wZuck/DELTA-OMEGA-KS-33-Ver./README.md

[English](README.md) | [简体中文](README.zh-CN.md)

DELTA OMEGA KS-33 Ver.

# DELTA OMEGA KS-33 Ver.

A portable low-profile wireless 3×5+2 split keyboard.

> [!IMPORTANT]
> DELTA OMEGA KS-33 Ver. is a modification of the original DELTA OMEGA design,
> converted to the **Gateron KS-33 Low Profile 3.0 five-pin** switch platform.
> The split wireless architecture and compact 3×5+2 layout are retained. The
> main changes are the KS-33 PCB footprints, matrix routing and validation,
> direct-solder switch installation, KS-33-specific case clearance with a
> raised outer rim, the matching keycap fit envelope, and updated firmware,
> BOM, build, and mechanical documentation. The original Rev4 ULP PCB and
> Gerbers remain available for reference.

## Overview

- Switch support: Gateron KS-33 Low Profile 3.0, five-pin MX PCB layout
- 34 keys, splayed and staggered with 18 × 17 mm key pitch
- Wireless
- CNC aluminum case

## Parameters

Dimension

Layout

## Documentation

> [!NOTE]
> Rev5 is a **five-pin low-profile MX** build. It keeps the compact 18 × 17 mm layout, so keycap footprint must be checked before ordering: standard 19.05 mm-spaced MX keycaps can interfere between rows. The original Rev4 ULP PCB and Gerbers remain in the repository for reference.

- [Getting Started](./docs/GETTING_STARTED.md)
- [Rev5 Mechanical Notes](./docs/MECHANICAL.md)
- [Rev5 Review Summary](./docs/REVIEW_REV5.md)
- [Bill of Materials](./docs/BOM.md)
- [Build Guides](./docs/BUILD_GUIDES.md)
- [Video](https://youtu.be/UktrqN3MlLI)
- [PCB](./pcb/README.md)
- [Case](./case/README.md)
- [Firmware Notes](./firmware/README.md)
- [ZMK Keyboard Module](https://github.com/unspecworks/zmk-keyboard-delta-omega)
- [Pre-conf ZMK Config](https://github.com/unspecworks/zmk-delta-omega)
- Keycaps
  - [Rev5 fit envelope and requirements](./docs/MECHANICAL.md)

## Photos

- [Gallery](./gallery/README.md)
- [Prototype Gallery](./images/README.md)
  - Diff: Port position, Thumb-cluster layout and only hot-plate way.

## Acknowledgments and Inspirations

- [GEIGEIGEIST/TOTEM](https://github.com/GEIGEIGEIST/TOTEM)
- [mikeholscher/zmk-config-mikecinq](https://github.com/mikeholscher/zmk-config-mikecinq)
- [pashutk/Cherry_MX_ULP](https://github.com/pashutk/Cherry_MX_ULP)
- [zmk-rgbled-widget](https://github.com/caksoylar/zmk-rgbled-widget)
- [infused-kim/kb_ergogen_fp](https://github.com/infused-kim/kb_ergogen_fp)
- [ceoloide/ergogen-footprints](https://github.com/ceoloide/ergogen-footprints)
- [kiswitch/kiswitch](https://github.com/kiswitch/kiswitch)

## Limitations and Disclaimer

This is a hobby-driven project. Some aspects may be incomplete, imperfect, or problematic. Use this project **at your own risk**, and note that no warranties or guarantees are provided.

## License

DELTA OMEGA KS-33 Ver. is licensed under [CERN-OHL-W-2.0](./LICENSE.md).

See [NOTICE.md](./NOTICE.md) for the Rev5 modification notice and
[THIRD_PARTY_NOTICES.md](./THIRD_PARTY_NOTICES.md) for third-party components,
licences, names, and source status.

footer
