wZuck/DELTA-OMEGA-KS-33-Ver./case/README.md

[English](README.md) | [简体中文](README.zh-CN.md)

# Case

The Rev5 case is derived from the Rev2 outer shell, keeps its screw pattern,
raises the outer rim from `z = 7.0 mm` to `z = 8.8 mm`, and adds a `15.2 mm`,
`r1.8 mm` clearance pocket around every KS-33 switch. The raised rim is nearly
level with the `z = 9.0 mm` keycap envelope for a more enclosed typing feel. Use
the Rev5 STEP files for manufacturing.

- [Rev5 mechanical notes](../docs/MECHANICAL.md)
- [Keycap fit envelope](./delta_omega_rev5_keycap_envelope.step)

### Default Case STEP Files
- `delta_omega_rev5_left.step`
- `delta_omega_rev5_right.step`

The original `delta_omega_rev2_left.step` and
`delta_omega_rev2_right.step` remain as source references.

### Thread Annotation Drawings
These images **must be uploaded when placing an order** to ensure correct threading specifications:
- `delta_omega_rev2_left_thread.png`
- `delta_omega_rev2_right_thread.png`

---

## How to Order

This instructions are **based on JLC CNC**. While other CNC manufacturing services may follow slightly different requirements, in practice most specifications are very similar.

- **Material**: Aluminum 6061 (or something)
- **Surface Finish**: Bead blasting + anodizing recommended
- **Tightest Tolerance**: ISO 2768 (medium) is sufficient
- **Surface Roughness**: Ra3.2 is sufficient
- **Threads**: Yes. be sure to upload the thread annotation images (`left` / `right`) with your order
