wZuck/DELTA-OMEGA-KS-33-Ver./images/README.md

[English](README.md) | [简体中文](README.zh-CN.md)

# Prototype Gallery

d1
d2
d3
d4
d5
d6
d7
d8
d9
d10
