wZuck/DELTA-OMEGA-KS-33-Ver./docs/REVIEW_REV5.zh-CN.md

[English](REVIEW_REV5.md) | [简体中文](REVIEW_REV5.zh-CN.md)

# Rev5 审查结论

## PCB 与电路

- 左板、右板和拼板 KiCad DRC 均为 0 违规、0 未连接。
- 34 个键位没有重复或缺失的矩阵坐标。
- 每个轴体均串联一只 SOD-323 二极管；焊盘 1 接行，焊盘 2 接轴体和列，固件使用 `col2row`。
- 左手五列对应全局 0-4 列；右手按相反 GPIO 顺序接全局 5-9 列。
- BATP、LED 限流电阻、复位、C2 列链和分裂的地铜皮岛均已有显式连接。
- 信号走线最小宽度为 0.2 mm。
- XIAO 邮票孔是唯一的铜到板边例外，并通过工程自定义规则仅作用于 `MCU1`/`MCU2`，没有全局关闭板边检查。

## 外壳与键帽

- Rev5 外壳为全部 34 个轴位增加了 `15.2 mm`、`r1.8 mm` 的可加工圆角让位，KS-33 3.0 圆角轴体包络为零干涉。
- 键帽必须使用圆角外形：`z = 7.0 mm` 以下为 `14 × 14 mm`、`r3.5 mm`，以上为 `16.6 × 15.6 mm`、`r7.0 mm`；相邻键帽碰撞检查通过。
- 电气脚必须剪到 PCB 背面剩余不超过 0.5 mm，并在安装底盖前绝缘。
- Rev5 壳沿提高到 `z = 8.8 mm`，与 `z = 9.0 mm` 的键帽包络顶部基本齐平，同时保持内部开口和安装结构不变。

精确尺寸和复核命令见 [机械说明](MECHANICAL.zh-CN.md)。

## 固件

- 行 GPIO 为 `D5`、`D6`、`D8`、`D7`；左手列为 `D0`-`D4`；右手列为 `D4`-`D0`，并设置列偏移 5。
- RGB 数据网络使用 `D9`（`P0.10`）。
- 核对的外部 keymap 中 `R_Gui_Alt` 曾有一处修饰键错误。当前[受控固件快照](../firmware/README.zh-CN.md)已包含修复、固定依赖版本和工作区初始化脚本。
- 当前工作区没有 west workspace 和 Zephyr 工具链，因此未执行完整 ZMK 编译。

## 首版实物验证

量产前仍需确认：

1. KS-33 3.0 样品能无阻力装入全部五个孔位。
2. 所选键帽在完整行程内不会碰外壳或相邻键帽。
3. 剪脚和绝缘后，电池与底盖仍有足够间隙。
4. 拼板邮票孔分离时不会损伤边缘走线或邮票孔焊盘。
5. 左右半板能使用固定版本的 ZMK 构建正常枚举和配对。
