wZuck/DELTA-OMEGA-KS-33-Ver./gallery/README.md

[English](README.md) | [简体中文](README.zh-CN.md)

# Gallery

d21
d21
d21
d21
d21
d21
d21
d21
d1
d2
d3
d4
d5
d5
d5
d5
d10
d10
