wZuck/DELTA-OMEGA-KS-33-Ver./NOTICE.zh-CN.md

[English](NOTICE.md) | [简体中文](NOTICE.zh-CN.md)

# DELTA OMEGA KS-33 Ver. 修改通知

本仓库包含对以下原始 DELTA OMEGA 开源硬件项目的修改：

https://github.com/unspecworks/delta-omega

修改版源码位置：

https://github.com/wZuck/delta-omega

原始仓库基线：提交 `ddba616`。

修改日期：2026-10-17。

修改内容摘要：

- 将 ULP 轴体方案替换为直焊 Gateron KS-33 Low Profile 3.0 五脚轴。
- 增加 SOD-323 二极管位置，并重新生成左右板及拼板布线、Gerber 和钻孔文件。
- 增加 Rev5 外壳让位几何和键帽允许包络。
- 增加固件配置、验证脚本、中英文文档和生产可复现信息。

本仓库明确覆盖的 DELTA OMEGA KS-33 Ver. 修改版硬件源码使用 CERN Open
Hardware Licence Version 2 - Weakly Reciprocal（`CERN-OHL-W-2.0`）。完整许可证
保留在 `LICENSE.md`。

修改后 Covered Source 的首选 Source Location：

https://github.com/wZuck/delta-omega

分发基于本源码制造的实体产品时，必须向接收者提供 Complete Source，或按
CERN-OHL-W-2.0 第 4.1 节明确告知上述 Source Location。

第三方组件、工具、名称和材料另见 `THIRD_PARTY_NOTICES.zh-CN.md`。本通知不表示原作者、
CERN、Gateron 或任何其他第三方提供背书。
