wZuck/DELTA-OMEGA-KS-33-Ver./THIRD_PARTY_NOTICES.md

[English](THIRD_PARTY_NOTICES.md) | [简体中文](THIRD_PARTY_NOTICES.zh-CN.md)

# Third-Party Notices

This file records third-party material referenced by or distributed with the
DELTA OMEGA KS-33 Ver. repository. It does not replace the original licence
text of any third-party project.

## ZMK

The firmware is built with ZMK, which is distributed under the MIT License:

```text
MIT License

Copyright (c) 2020 The ZMK Contributors

Permission is hereby granted, free of charge, to any person obtaining a copy
of this software and associated documentation files (the "Software"), to deal
in the Software without restriction, including without limitation the rights
to use, copy, modify, merge, publish, distribute, sublicense, and/or sell
copies of the Software, and to permit persons to whom the Software is
furnished to do so, subject to the following conditions:

The above copyright notice and this permission notice shall be included in all
copies or substantial portions of the Software.

THE SOFTWARE IS PROVIDED "AS IS", WITHOUT WARRANTY OF ANY KIND, EXPRESS OR
IMPLIED, INCLUDING BUT NOT LIMITED TO THE WARRANTIES OF MERCHANTABILITY,
FITNESS FOR A PARTICULAR PURPOSE AND NONINFRINGEMENT. IN NO EVENT SHALL THE
AUTHORS OR COPYRIGHT HOLDERS BE LIABLE FOR ANY CLAIM, DAMAGES OR OTHER
LIABILITY, WHETHER IN AN ACTION OF CONTRACT, TORT OR OTHERWISE, ARISING FROM,
OUT OF OR IN CONNECTION WITH THE SOFTWARE OR THE USE OR OTHER DEALINGS IN THE
SOFTWARE.
```

Source: https://github.com/zmkfirmware/zmk

## zmk-rgbled-widget

The RGB LED widget is distributed under the MIT License:

```text
MIT License

Copyright (c) 2023 Cem Aksoylar

Permission is hereby granted, free of charge, to any person obtaining a copy
of this software and associated documentation files (the "Software"), to deal
in the Software without restriction, including without limitation the rights
to use, copy, modify, merge, publish, distribute, sublicense, and/or sell
copies of the Software, and to permit persons to whom the Software is
furnished to do so, subject to the following conditions:

The above copyright notice and this permission notice shall be included in all
copies or substantial portions of the Software.

THE SOFTWARE IS PROVIDED "AS IS", WITHOUT WARRANTY OF ANY KIND, EXPRESS OR
IMPLIED, INCLUDING BUT NOT LIMITED TO THE WARRANTIES OF MERCHANTABILITY,
FITNESS FOR A PARTICULAR PURPOSE AND NONINFRINGEMENT. IN NO EVENT SHALL THE
AUTHORS OR COPYRIGHT HOLDERS BE LIABLE FOR ANY CLAIM, DAMAGES OR OTHER
LIABILITY, WHETHER IN AN ACTION OF CONTRACT, TORT OR OTHERWISE, ARISING FROM,
OUT OF OR IN CONNECTION WITH THE SOFTWARE OR THE USE OR OTHER DEALINGS IN THE
SOFTWARE.
```

Source: https://github.com/caksoylar/zmk-rgbled-widget

## Separately Published DELTA OMEGA Firmware Sources

The local firmware configuration was reviewed against these separately
published repositories:

- `unspecworks/zmk-delta-omega` at
  `0f5392e87467c06d0d23c321b1728cc1539be950`
- `unspecworks/zmk-keyboard-delta-omega` at
  `1df759db142469929841464905ec831ddb4e29b8`

At the time of this review, their repositories did not contain a separate
licence file. They are not automatically relicensed by the original
DELTA OMEGA repository's CERN-OHL-W-2.0 notice. The applicable rights holder
must confirm redistribution terms or add an explicit licence before these
copied files are redistributed as open source.

## Gateron KS-33

Gateron, KS-33, and related product names and marks belong to their respective
owners. The repository cites official switch dimensions for compatibility and
does not include copied Gateron CAD models, product photographs, or the
official PDF.

Official dimensions reference:

https://www.gateron.com/u_file/2610/12/file/GATERONKS-33LowProfile30MechanicalSilverSwitchSet.pdf

Use of the Gateron name is factual and does not imply sponsorship, endorsement,
or certification by Gateron.

## DELTA OMEGA Name and Branding

CERN-OHL-W-2.0 does not grant rights to names, images, or logos of the
Licensor or CERN. This repository is a modified DELTA OMEGA design. Published
forks should clearly identify themselves as modified or derivative versions
and must not imply endorsement by the original author.
