wZuck/DELTA-OMEGA-KS-33-Ver./THIRD_PARTY_NOTICES.zh-CN.md

[English](THIRD_PARTY_NOTICES.md) | [简体中文](THIRD_PARTY_NOTICES.zh-CN.md)

# 第三方声明

本文件记录 DELTA OMEGA KS-33 Ver. 仓库引用或随附的第三方内容，不替代任何第三方项目的原始许可证文本。

## ZMK

固件使用 ZMK。ZMK 采用 MIT 许可证，版权声明为
`Copyright (c) 2020 The ZMK Contributors`。许可证原文和完整条款见
[ZMK LICENSE](https://github.com/zmkfirmware/zmk/blob/v0.3/LICENSE)。

分发 ZMK 的副本或实质性部分时，必须保留其版权声明和 MIT 许可证文本。

## zmk-rgbled-widget

RGB LED 组件采用 MIT 许可证，版权声明为
`Copyright (c) 2023 Cem Aksoylar`。许可证原文见
[zmk-rgbled-widget LICENSE](https://github.com/caksoylar/zmk-rgbled-widget/blob/main/LICENSE)。

分发其副本或实质性部分时，必须保留其版权声明和 MIT 许可证文本。英文页面包含完整 MIT 文本，并作为许可证原文。

## 单独发布的 DELTA OMEGA 固件源码

本地固件配置已按以下单独发布的仓库版本核对：

- `unspecworks/zmk-delta-omega`
  `0f5392e87467c06d0d23c321b1728cc1539be950`
- `unspecworks/zmk-keyboard-delta-omega`
  `1df759db142469929841464905ec831ddb4e29b8`

审核时，这两个仓库中没有单独的许可证文件。它们不会因原始 DELTA OMEGA 仓库采用
CERN-OHL-W-2.0 而自动改为该许可证。复制文件开源发布前，必须由适用版权持有人确认分发条款，或补充明确许可证。

## Gateron KS-33

Gateron、KS-33 及相关产品名称和商标归各自权利人所有。本仓库仅引用官方轴体尺寸用于兼容性说明，没有包含复制的 Gateron CAD 模型、产品照片或官方 PDF。

官方尺寸参考：

https://www.gateron.com/u_file/2610/12/file/GATERONKS-33LowProfile30MechanicalSilverSwitchSet.pdf

对 Gateron 名称的使用仅用于事实说明，不表示 Gateron 提供赞助、背书或认证。

## DELTA OMEGA 名称与品牌

CERN-OHL-W-2.0 不授予 Licensor 或 CERN 的名称、图片或 Logo 使用权。本仓库是 DELTA OMEGA 的修改版设计；公开分支应明确说明其为修改版或派生版本，不得暗示原作者提供背书。
