wZuck/DELTA-OMEGA-KS-33-Ver./docs/images/rev5_ks33_right.png

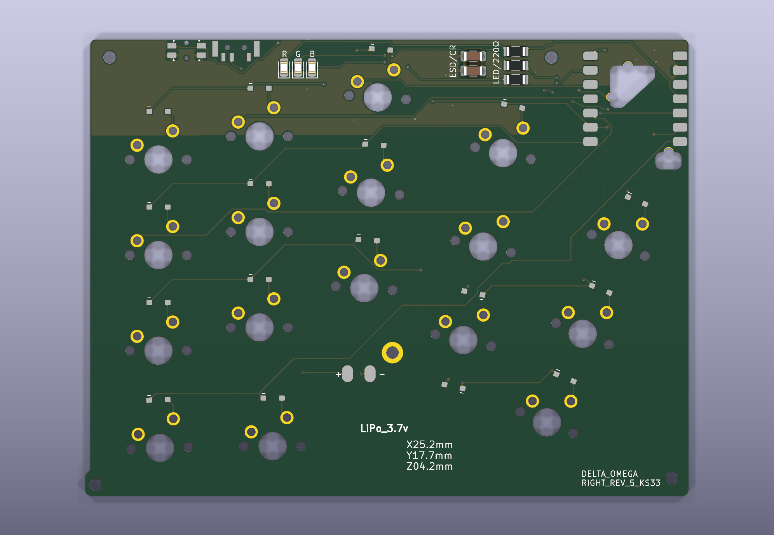
docs/images/rev5_ks33_right.png
