wZuck/DELTA-OMEGA-KS-33-Ver./docs/BOM.zh-CN.md

[English](BOM.md) | [简体中文](BOM.zh-CN.md)

# 物料清单

| 元件 | 规格 | 数量 | 备注 |
|---|---|---:|---|
| MCU 控制器 | SeeedStudio XIAO nRF52840 | 2 | |
| 低高度 MX 轴体 | Gateron KS-33 Low Profile 3.0 五脚；参考型号 `KS-33BS10B043NW-Y92B` | 34 | 直焊，不支持热插拔；采购时核对 3.0 代 PCB 图纸 |
| 低高度 MX 键帽 | MX 轴心；z=7 以下 14×14、r3.5，z=7 以上 16.6×15.6、r7 | 34 | 壳沿为 z=8.8；详见机械说明 |
| 电源开关 | MK-12C02 | 2 | |
| 复位开关 | EVQ-PUL02K | 2 | 兼容 EVQ-PU[A\|C\|J\|L]02K |
| 二极管 | SOD-323 | 34 | 1N4148WS |
| 电池 | 3.7 V Li-Po | 2 | 最大尺寸：25.2 mm × 17.7 mm × 4.2 mm |
| 螺丝 | M2 × 3 mm | 10 | 不使用沉头时，请选择超低头螺丝，例如 0.8 mm 头高 |
| LED | 0805（2012 公制） | 6 | 可选 |
| LED 电阻 | 1206（3216 公制），220Ω–470Ω | 6 | 可选 |
| 磁铁 | 圆片，外径 8 mm，厚 3 mm，至少 N52 | 6 | 可选 |
| ESD 保护电容 | 1206（3216 公制），1 nF 50 V [C0G\|NP0\|X7R] | 2 | 可选 |
| ESD 保护电阻 | 1206（3216 公制），1 MΩ | 2 | 可选 |

## 下一步

- [装配指南](./BUILD_GUIDES.zh-CN.md)
