wZuck/DELTA-OMEGA-KS-33-Ver./case/delta_omega_rev5_right.step

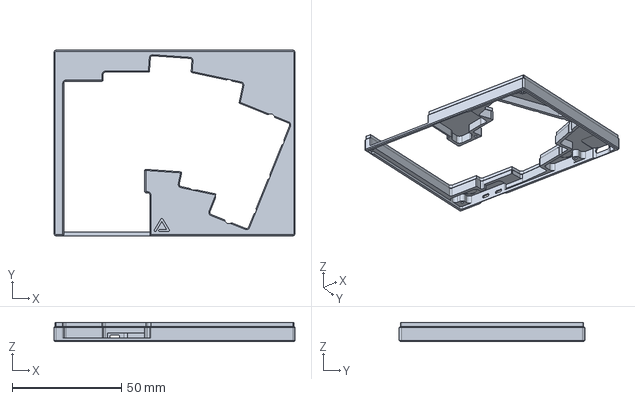
[picture p4: CAD file, 2026-10-17]
case/delta_omega_rev5_right.step
110.2 x 84.9 x 8.80 mm
