wZuck/DELTA-OMEGA-KS-33-Ver./case/delta_omega_rev5_keycap_envelope.step

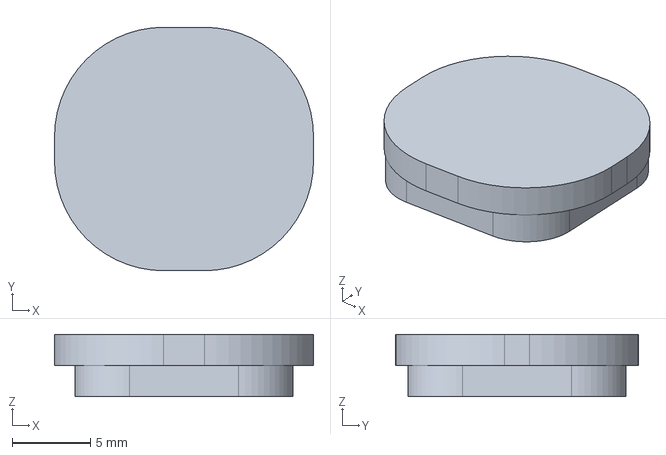
[picture p5: CAD file, 2026-10-17]
case/delta_omega_rev5_keycap_envelope.step
16.6 x 15.6 x 4.00 mm
