wZuck/DELTA-OMEGA-KS-33-Ver./(list of files, cad)

Other CAD files:
case/delta_omega_rev5_left.step
