wZuck/DELTA-OMEGA-KS-33-Ver./docs/GETTING_STARTED.zh-CN.md

[English](GETTING_STARTED.md) | [简体中文](GETTING_STARTED.zh-CN.md)

# 入门指南

开始装配前请完整阅读本文档。内容可能较长，但每一节只保留了构建过程中最重要的信息。

## 第 1 步：选择轴体

Rev5 使用 **Gateron KS-33 Low Profile 3.0** 五脚 MX PCB 布局轴体。

Rev5 的轴体封装包含：

- 标准 MX 电气脚坐标
- 5.0 mm 中心孔
- 位于 ±5.08 mm 处的 1.70 mm 定位孔
- 直焊针脚，不支持热插拔

请务必使用 **3.0** 代产品。较早的 Gateron KS-33 使用不同的 PCB 针脚布局，不能直接用于本板。

原始 Rev4 文件仍支持 Cherry MX ULP 或 Kailh PG1316S，供需要构建旧版方案的用户使用。

参考：[Gateron KS-33 Low Profile 3.0](https://www.gateron.com/products/gateron-ks-33-low-profile-30-mechanical-switch)

## 键帽

DELTA OMEGA KS-33 Ver. 使用 **18 × 17 mm 键距**。KS-33 3.0 虽然使用 MX 兼容轴心，但并非所有 MX 键帽都能装入。

- 使用底部尺寸紧凑、能够在 17 mm 行距下保持间隙的低高度 MX 键帽。
- 最终装配前先试排相邻键帽。标准 19.05 mm 行距的 MX 键帽可能在行间碰撞。
- 自定义打印的低高度 MX 键帽通常最容易控制尺寸。

Rev5 键帽允许包络

### 高度注意事项

Rev5 外壳为每个轴位增加了 `15.2 mm`、`r1.8 mm` 少量让位，并已按全部 34 个轴位核对 KS-33 3.0 轴体。键帽必须使用圆角包络：`z = 7.0 mm` 以下为 `14 × 14 mm`、`r3.5 mm`，以上为 `16.6 × 15.6 mm`、`r7.0 mm`。选择或设计键帽前，请阅读 [Rev5 机械说明](MECHANICAL.zh-CN.md) 并检查给定 STEP 包络。

Rev5 外壳顶沿提高到 `z = 8.8 mm`，与 `z = 9.0 mm` 的键帽包络顶部基本齐平，从而获得更包覆的操作体感；内部开口和安装结构保持不变。

## 焊接

KS-33 3.0 针脚和独立 1N4148WS 二极管均按手工焊接设计，不需要热板或回流焊。

1. 先焊接 SOD-323 二极管，再安装轴体。
2. 干装每个轴体，五个定位结构都必须无阻力插入。
3. 从 PCB 背面焊接两个电气脚。
4. 不要向中心孔或定位孔中填锡。
5. 将电气脚剪到 PCB 背面剩余不超过 0.5 mm，并在安装底盖前绝缘所有裸露金属。

## PCB

### 主 PCB

PCB **不可翻转复用**，左右手需要分别制作。

下单方式有两种：

1. 使用包含左右板的单份 Gerber
2. 分别下单左右 PCB

**原因：**左右板拼在一起时需要使用邮票孔或 V-Cut 分离，边缘会留下毛刺。DELTA OMEGA KS-33 Ver. 的底部 PCB 会外露，毛刺和严格公差可能造成装配问题。

两种方式的成本差异通常只有约 1–2 美元，可按偏好选择。

### PCB 厚度

PCB 堆叠

Rev5 要求：

- 主板固定使用 **1.6 mm PCB**。KS-33 定位柱长 1.2 mm，电气脚长 3.0 mm。
- 可按需要增加 0.8 mm PCB 底盖，但不改变主板厚度。

旧 Rev4 的 0.8 mm 主板叠层方案不建议用于 Rev5。

> [!TIP]
> 底盖可以制作沉头孔，以获得平整底面。但 0.8 mm 板材不足以加工出完美沉头，左半板右下角尤其困难。

> [!TIP]
> 也可以在底盖上加入自己的图案或定制设计。

## 外壳

推荐使用 **CNC 铝合金**外壳。由于设计追求轻薄和便携，刚性材料能提供更好的耐用性。

### 成本

CNC 加工通常是最大的成本来源。

- JLC CNC（6061 铝合金，喷砂 + 阳极氧化）：约 **每侧 32 美元**
- 价格会变化，以上仅作粗略参考

> [!TIP]
> 多人一起下单通常可以显著降低成本，单侧可能降至约 30 美元。优惠券和其他 CNC 厂商也可能进一步降低费用。

PCB 加 CNC 外壳的合计成本通常在 **80–100 美元**左右，不含运费和税费。

### 磁铁

外壳内可以安装三组磁铁，使左右两半在携带时吸附在一起。

- 磁铁为可选项；如果担心划伤，可以使用其他收纳方式。
- 推荐规格请参考物料清单中已测试的尺寸。

### JLC CNC 使用经验

原型阶段大约向 JLCCNC 下过六次订单。整体质量可以接受，但可能存在轻微倒角不均和表面划痕；其中一件存在轻微翘曲。考虑到薄壁和中空结构，这属于需要预留的风险。本项目遇到过约 0.3 mm 的形变偏差，需要手工微调。

如果遇到类似问题，建议直接与 JLC 沟通并协商解决方案。

## LED 指示灯

LED 指示灯

设计使用三颗独立 LED 作为间接发光指示灯。颜色可按偏好选择，默认配置为红、绿、蓝。可通过 [zmk-rgbled-widget](https://github.com/caksoylar/zmk-rgbled-widget) 文档调整显示效果。

在 3.3 V 下使用 LED 时，建议安装合适的限流电阻。电阻越低，亮度越高，但电池消耗和 MCU 负载也会增加。相同阻值下，不同颜色 LED 的亮度也可能不同。若不确定，220Ω 通常是安全且有效的起点。

## 电池

可使用 3.7 V Li-Po 电池，尺寸必须控制在 **25.2 mm × 17.7 mm × 4.2 mm** 以内。

常见 **401725** 型号可能无法正确装入，因为标称尺寸通常不包含保护板，而且软包电池本身存在较大尺寸公差。

购买前务必核对实际尺寸。不要强行塞入电池。

---

## 下一步

- [物料清单](./BOM.zh-CN.md)
- [装配指南](./BUILD_GUIDES.zh-CN.md)
