wZuck/DELTA-OMEGA-KS-33-Ver./pcb/delta-omega-rev5-ks33-both.kicad_pcb

## KiCad design pcb/delta-omega-rev5-ks33-both.kicad_pcb (2026-10-17)

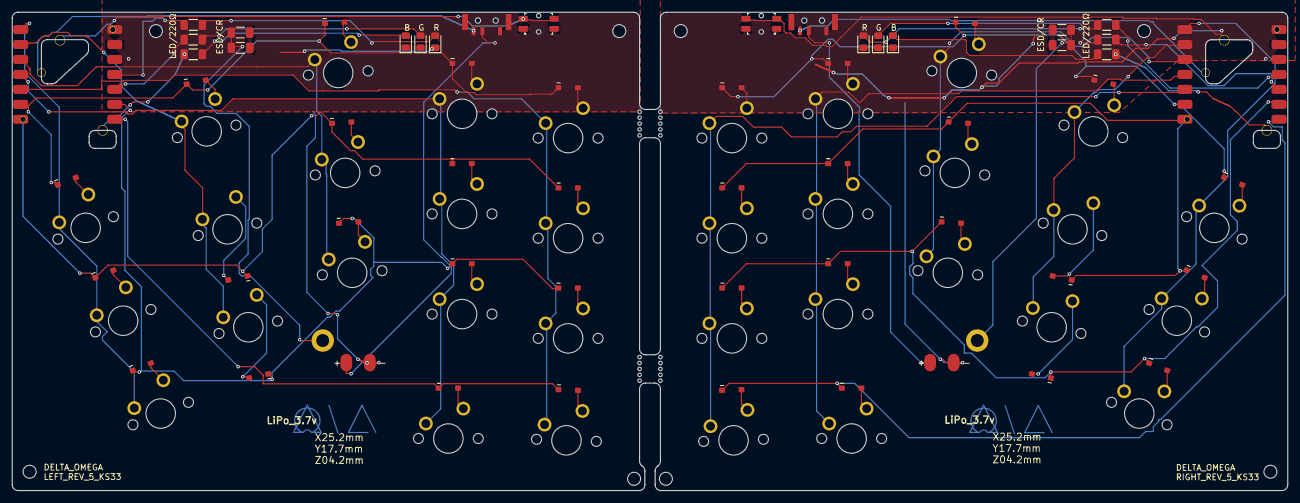
[picture p7: board delta-omega-rev5-ks33-both.kicad_pcb from above]

Board: 2 copper layers, 216.5 x 81.2 mm, 100 parts (0 on the bottom side), 70 nets.

Parts:
C1, C1#2: C_1206_3216Metric_Pad1.33x1.80mm_HandSolder
D1, D2, D3, D4, D5, D6, D7, D8, D9, D10, D11, D12, D13, D14, D15, D16, D17, D18, D19, D20, D21, D22, D23, D24, D25, D26, D27, D28, D29, D30, D31, D32, D33, D34: 1N4148WS
H1, H2: (no value)
L1, L1#2, L2, L2#2, L3, L3#2: LED_0805_2012Metric_Pad1.15x1.40mm_HandSolder
MCU1, MCU2: XIAO-nRF52840-SMD
MH1, MH2, MH3, MH4, MH5, MH6, MH7, MH8: (no value)
R1, R1#3, R2, R2#2, R3, R3#2: R_1206_3216Metric_Pad1.30x1.75mm_HandSolder
R1#2, R1#4: C_1206_3216Metric_Pad1.33x1.80mm_HandSolder
RST1, RST2: (no value)
SW1, SW2, SW3, SW4, SW5, SW6, SW7, SW8, SW9, SW10, SW11, SW12, SW13, SW14, SW15, SW16, SW17, SW18, SW19, SW20, SW21, SW22, SW23, SW24, SW25, SW26, SW27, SW28, SW29, SW30, SW31, SW32, SW33, SW34: KS33_LP_3.0_5Pin
TH1, TH2: (no value)

Connections:
L_C1: MCU2.1, SW1.1, SW2.1, SW3.1
L_C2: MCU2.2, SW4.1, SW5.1, SW6.1
L_C3: MCU2.3, SW7.1, SW8.1, SW9.1
L_C4: MCU2.4, SW10.1, SW11.1, SW12.1, SW16.1
L_C5: MCU2.5, SW13.1, SW14.1, SW15.1, SW17.1
L_CGND: C1#2.1, R1#2.1
L_GND: C1#2.2, L1.1, L2#2.1, L3#2.1, MCU2.13, R1#2.2, RST1.2, RST1.4, TH1.1
L_LED1: L1.2, R1#3.2
L_LED2: L2#2.2, R2#2.2
L_LED3: L3#2.2, R3#2.2
L_LED_R1: MCU2.11, R1#3.1
L_LED_R2: MCU2.10, R2#2.1
L_LED_R3: MCU2.17, R3#2.1
L_R1: D3.1, D6.1, D9.1, D12.1, D15.1, MCU2.6
L_R2: D2.1, D5.1, D8.1, D11.1, D14.1, MCU2.7
L_R3: D1.1, D4.1, D7.1, D10.1, D13.1, MCU2.9
L_R4: D16.1, D17.1, MCU2.8
L_RST: MCU2.21, RST1.1, RST1.3
R_C1: MCU1.1, SW18.1, SW19.1, SW20.1
R_C2: MCU1.2, SW21.1, SW22.1, SW23.1
R_C3: MCU1.3, SW24.1, SW25.1, SW26.1
R_C4: MCU1.4, SW27.1, SW28.1, SW29.1, SW33.1
R_C5: MCU1.5, SW30.1, SW31.1, SW32.1, SW34.1
R_CGND: C1.2, R1#4.2
R_GND: C1.1, L1#2.1, L2.1, L3.1, MCU1.13, R1#4.1, RST2.2, RST2.4, TH2.1
R_LED1: L1#2.2, R1.1
R_LED2: L2.2, R2.1
R_LED3: L3.2, R3.1
R_LED_R1: MCU1.11, R1.2
R_LED_R2: MCU1.10, R2.2
R_LED_R3: MCU1.17, R3.2
R_R1: D20.1, D23.1, D26.1, D29.1, D32.1, MCU1.6
R_R2: D19.1, D22.1, D25.1, D28.1, D31.1, MCU1.7
R_R3: D18.1, D21.1, D24.1, D27.1, D30.1, MCU1.9
R_R4: D33.1, D34.1, MCU1.8
R_RST: MCU1.21, RST2.1, RST2.3
SW1_1: D1.2, SW1.2
SW2_1: D2.2, SW2.2
SW3_1: D3.2, SW3.2
SW4_1: D4.2, SW4.2
SW5_1: D5.2, SW5.2
SW6_1: D6.2, SW6.2
SW7_1: D7.2, SW7.2
SW8_1: D8.2, SW8.2
SW9_1: D9.2, SW9.2
SW10_1: D10.2, SW10.2
SW11_1: D11.2, SW11.2
SW12_1: D12.2, SW12.2
SW13_1: D13.2, SW13.2
SW14_1: D14.2, SW14.2
SW15_1: D15.2, SW15.2
SW16_1: D16.2, SW16.2
SW17_1: D17.2, SW17.2
SW18_1: D18.2, SW18.2
SW19_1: D19.2, SW19.2
SW20_1: D20.2, SW20.2
SW21_1: D21.2, SW21.2
SW22_1: D22.2, SW22.2
SW23_1: D23.2, SW23.2
SW24_1: D24.2, SW24.2
SW25_1: D25.2, SW25.2
SW26_1: D26.2, SW26.2
SW27_1: D27.2, SW27.2
SW28_1: D28.2, SW28.2
SW29_1: D29.2, SW29.2
SW30_1: D30.2, SW30.2
SW31_1: D31.2, SW31.2
SW32_1: D32.2, SW32.2
SW33_1: D33.2, SW33.2
SW34_1: D34.2, SW34.2
